ladecadence/RaccoonBoard-PCB/RaccoonBoard.kicad_pcb

## KiCad design RaccoonBoard.kicad_pcb (2020-12-12)

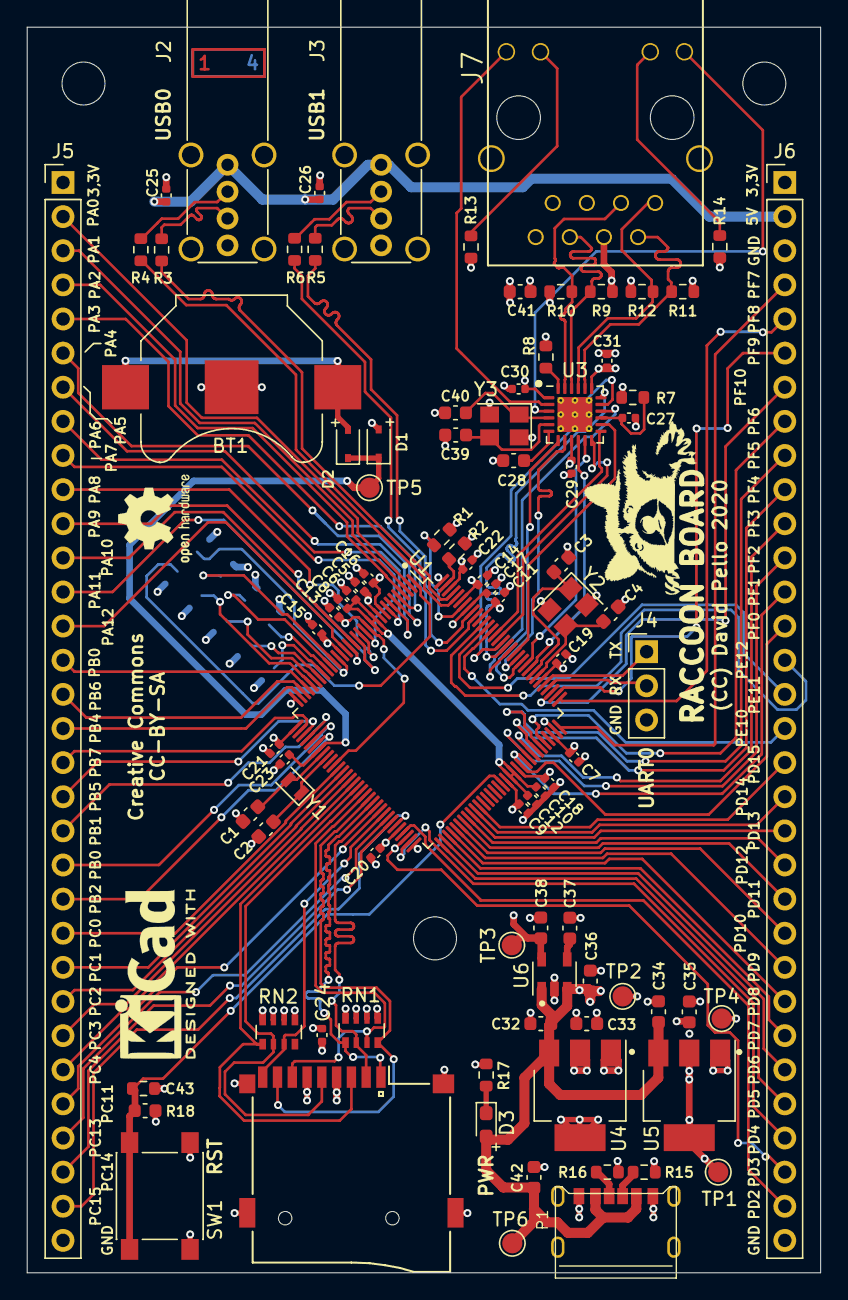
[picture p1: board RaccoonBoard.kicad_pcb from above]

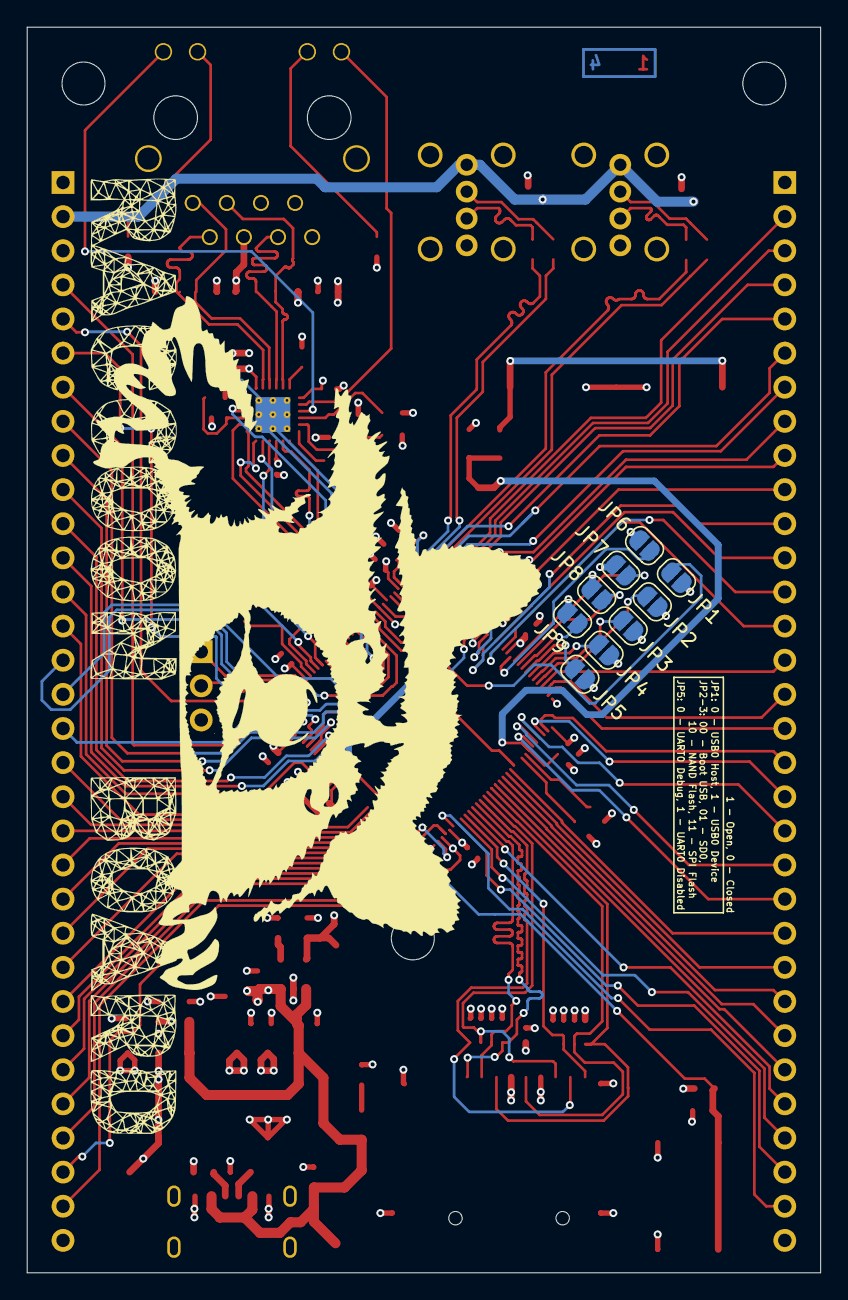
[picture p2: board RaccoonBoard.kicad_pcb from below]

Board: 4 copper layers, 59.1 x 92.7 mm, 99 parts (9 on the bottom side), 125 nets.

Parts:
BT1: 3V; Keystone_3000_1x12mm-CoinCell
C1, C2, C3, C4, C39, C40: C; C_0603_1608Metric
C5, C6, C7, C8, C9, C10, C11, C12, C13, C14, C15, C16, C17, C18, C19, C20, C21, C22, C23, C24, C25, C26, C27, C29, C30, C31: 100n; C_0402_1005Metric
C28, C32, C33, C34, C35, C36, C38, C42, C43: 1u; C_0603_1608Metric
C37, C41: 10n; C_0603_1608Metric
D1, D2: BAT43WS; D_SOD-323
D3: PWR; LED_0603_1608Metric_Pad1.05x0.95mm_HandSolder
J1: BOOT SD; Conn_uSDcard
J2, J3: USB_A; USB_A_Vertical
J4: UART0; PinHeader_1x03_P2.54mm_Vertical
J5: IO1; PinHeader_1x32_P2.54mm_Vertical
J6: IO2; PinHeader_1x32_P2.54mm_Vertical
J7: HR911105A; HR911105a
JP1: USB0ID; SolderJumper-2_P1.3mm_Open_RoundedPad1.0x1.5mm
JP2: PG0; SolderJumper-2_P1.3mm_Open_RoundedPad1.0x1.5mm
JP3: PG1; SolderJumper-2_P1.3mm_Open_RoundedPad1.0x1.5mm
JP4: PG3; SolderJumper-2_P1.3mm_Open_RoundedPad1.0x1.5mm
JP5: PG5; SolderJumper-2_P1.3mm_Open_RoundedPad1.0x1.5mm
JP6: PG9; SolderJumper-2_P1.3mm_Open_RoundedPad1.0x1.5mm
JP7: PG8; SolderJumper-2_P1.3mm_Open_RoundedPad1.0x1.5mm
JP8: PG7; SolderJumper-2_P1.3mm_Open_RoundedPad1.0x1.5mm
JP9: PG6; SolderJumper-2_P1.3mm_Open_RoundedPad1.0x1.5mm
P1: USB PWR; TYPE-C-31-M-17
R1, R2, R8: 12K1; R_0603_1608Metric
R3, R4, R5, R6: 4R7; R_0603_1608Metric
R7: 10K; R_0603_1608Metric
R9, R10, R11, R12: 49.9; R_0603_1608Metric
R13, R14, R17: 220; R_0603_1608Metric
R15, R16: 5K1; R_0603_1608Metric
R18: 100K; R_0603_1608Metric
RN1, RN2: 10K; R_Array_Convex_4x0603
SW1: RST; SW_Push_1P1T_NO_6x6mm_H9.5mm
TP1: 1.2; TestPoint_Pad_D1.5mm
TP2: 3.3; TestPoint_Pad_D1.5mm
TP3: 1.8; TestPoint_Pad_D1.5mm
TP4: GND; TestPoint_Pad_D1.5mm
TP5: VBATT; TestPoint_Pad_D1.5mm
TP6: VIN; TestPoint_Pad_D1.5mm
U1: NUC980DK61Y; LQFP-128_14x14mm_P0.4mm
U3: LAN8720A; QFN-24-1EP_4x4mm_P0.5mm_EP2.6x2.6mm_ThermalVias
U4: AP1117-33; SOT-223-3_TabPin2
U5: AZ1117-1.2; SOT-223-3_TabPin2
U6: LP2985-1.8; SOT-23-5
Y1: 32K; Crystal_SMD_2012-2Pin_2.0x1.2mm
Y2: 12MHz; Crystal_SMD_3225-4Pin_3.2x2.5mm
Y3: 25MHz; Crystal_SMD_3225-4Pin_3.2x2.5mm

Connections:
+1V2: C5.1, C7.1, C9.1, C11.1, C13.1, C14.1, C35.1, TP1.1, U1.10, U1.13, U1.43, U1.82, U1.94, U1.118, U1.123, U5.2
+1V8: C6.1, C8.1, C10.1, C12.1, C38.1, TP3.1, U1.11, U1.12, U1.83, U1.84, U6.5
+3V3: C15.1, C16.1, C17.1, C18.1, C19.1, C20.1, C21.1, C22.1, C24.1, C29.1, C30.1, C31.1, C33.1, C41.1, D1.2, J1.4, J5.1, J6.1, J7.4, J7.5, R7.1, R9.1, R10.1, R11.1, R12.1, R18.1, RN1.5, RN1.6, RN1.7, RN1.8, RN2.5, RN2.6, RN2.7, RN2.8, TP2.1, U1.9, U1.20, U1.33, U1.60, U1.85, U1.102, U1.121, U1.126, U3.1, U3.9, U3.19, U4.2
+5V: C25.1, C26.1, C32.1, C34.1, C36.1, C42.1, D3.2, J2.1, J3.1, J6.2, P1.A9, P1.B9, TP6.1, U4.3, U5.3, U6.1, U6.3
+BATT: C23.1, D1.1, D2.1, TP5.1, U1.39
/D0+: J2.3, R3.1
/D0-: J2.2, R4.1
/D1+: J3.3, R5.1
/D1-: J3.2, R6.1
ETH_CRSDV: U1.106, U3.11
ETH_LED1: J7.9, U3.3
ETH_LED2: J7.12, U3.2
ETH_MDC: U1.114, U3.13
ETH_MDIO: U1.113, U3.12
ETH_REFCLK: U1.109, U3.14
ETH_RXD0: U1.108, U3.8
ETH_RXD1: U1.107, U3.7
ETH_RXERR: U1.105, U3.10
ETH_RX_N: J7.6, R9.2, U3.22
ETH_RX_P: J7.3, R10.2, U3.23
ETH_TXD0: U1.112, U3.17
ETH_TXD1: U1.111, U3.18
ETH_TXDEN: U1.110, U3.16
ETH_TX_N: J7.2, R11.2, U3.20
ETH_TX_P: J7.1, R12.2, U3.21
GND: BT1.2, C1.2, C2.2, C3.2, C4.2, C5.2, C6.2, C7.2, C8.2, C9.2, C10.2, C11.2, C12.2, C13.2, C14.2, C15.2, C16.2, C17.2, C18.2, C19.2, C20.2, C21.2, C22.2, C23.2, C24.2, C25.2, C26.2, C27.2, C28.2, C29.2, C30.2, C31.2, C32.2, C33.2, C34.2, C35.2, C36.2, C37.2, C38.2, C39.2, C40.2, C41.2, C42.2, C43.2, J1.6, J2.4, J2.5, J3.4, J3.5, J4.3, J5.32, J6.3, J6.32, J7.8, J7.13, J7.14, JP1.1, JP2.1, JP3.1, JP4.1, JP5.1, JP6.2, JP7.2, JP8.2, JP9.2, P1.A12, P1.B12, R1.2, R2.2, R8.2, R13.2, R14.2, R15.2, R16.2, R17.2, SW1.1, TP4.1, U1.32, U1.64, U1.95, U1.128, U3.25, U4.1, U5.1, U6.2, Y2.2, Y2.4, Y3.2, Y3.4
unnamed: BT1.1, D2.2
unnamed: C1.1, U1.40, Y1.2
unnamed: C2.1, U1.41, Y1.1
unnamed: C3.1, U1.104, Y2.1
unnamed: C4.1, U1.103, Y2.3
unnamed: C27.1, R7.2, U3.15
unnamed: C28.1, U3.6
unnamed: C37.1, U6.4
unnamed: C39.1, U3.5, Y3.3
unnamed: C40.1, U3.4, Y3.1
unnamed: D3.1, R17.1
unnamed: J7.10, R14.1
unnamed: J7.11, R13.1
unnamed: JP1.2, U1.1
unnamed: JP2.2, U1.28
unnamed: JP3.2, U1.27
unnamed: JP4.2, U1.26
unnamed: JP5.2, U1.25
unnamed: JP6.1, U1.21
unnamed: JP7.1, U1.22
unnamed: JP8.1, U1.23
unnamed: JP9.1, U1.24
unnamed: P1.A5, R16.1
unnamed: P1.B5, R15.1
unnamed: R1.1, U1.122
unnamed: R2.1, U1.127
unnamed: R8.1, U3.24
PA0: J5.2, U1.2
PA1: J5.3, U1.3
PA2: J5.4, U1.4
PA3: J5.5, U1.5
PA4: J5.6, U1.6
PA5: J5.7, U1.7
PA6: J5.8, U1.8
PA7: J5.9, U1.14
PA8: J5.10, U1.15
PA9: J5.11, U1.16
PA10: J5.12, U1.17
PA11: J5.13, U1.18
PA12: J5.14, U1.19
PB0: J5.15, U1.29
PB1: J5.20, U1.36
PB2: J5.22, U1.38
PB3: J5.21, U1.37
PB4: J5.17, U1.31
PB5: J5.19, U1.35
PB6: J5.16, U1.30
PB7: J5.18, U1.34
PC0: J5.23, U1.44
PC1: J5.24, U1.45
PC2: J5.25, U1.46
PC3: J5.26, U1.47
PC4: J5.27, U1.48
PC11: J5.28, U1.55
PC13: J5.29, U1.57
PC14: J5.30, U1.58
PC15: J5.31, U1.59
PD2: J6.31, U1.61
PD3: J6.30, U1.62
PD4: J6.29, U1.63
PD5: J6.28, U1.65
PD6: J6.27, U1.66
PD7: J6.26, U1.67
PD8: J6.25, U1.68
PD9: J6.24, U1.69
PD10: J6.23, U1.70
PD11: J6.22, U1.71
PD12: J6.21, U1.72
PD13: J6.20, U1.73
PD14: J6.19, U1.74
PD15: J6.18, U1.75
PE10: J6.17, U1.115
PE11: J6.16, U1.116
PE12: J6.15, U1.117
PF0: J6.14, U1.86
PF1: J6.13, U1.87
PF2: J6.12, U1.88
PF3: J6.11, U1.89
PF4: J6.10, U1.90
PF5: J6.9, U1.91
PF6: J6.8, U1.92
PF7: J6.4, U1.96
PF8: J6.5, U1.97
PF9: J6.6, U1.98
PF10: J6.7, U1.99
SD0CLK: J1.5, RN2.2, U1.50
SD0CMD: J1.3, RN2.1, U1.49
SD0DAT0: J1.7, RN1.3, U1.51
SD0DAT1: J1.8, RN1.4, U1.52
SD0DAT2: J1.1, RN1.1, U1.53
SD0DAT3: J1.2, RN1.2, U1.54
SD0DETECT: J1.9, RN2.3, U1.56
UART0RX: J4.2, U1.100
UART0TX: J4.1, U1.101
USB0D_N: R4.2, U1.124
USB0D_P: R3.2, U1.125
USB1D_N: R6.2, U1.119
USB1D_P: R5.2, U1.120
nRST: C43.1, R18.2, SW1.2, U1.81
