ladecadence/RaccoonBoard-PCB/(commit log)

2020-12-10 Initial import to github
    [RaccoonBoard.kicad_pcb, RaccoonBoard.sch]
2020-12-11 Improved USB and ETH routing (matched lengths/skew)
    [RaccoonBoard.kicad_pcb]
2020-12-11 Updated to lastest KiCAD libraries, improved silkscreens, small fixes to routing
    [RaccoonBoard.kicad_pcb, RaccoonBoard.sch]
2020-12-12 Added values to XTAL load capacitors
    [RaccoonBoard.sch]
2020-12-12 Moved pin1 mark
    [RaccoonBoard.kicad_pcb]
