ladecadence/RaccoonBoard-PCB/(notices)

Notices in the files:
RaccoonBoard.kicad_pcb:
Creative Commons
CC-BY-SA
